coddingtonbear/baofeng-uv5r-usb-charger/hardware/buuc.kicad_pcb

## KiCad design hardware/buuc.kicad_pcb (2017-10-15)

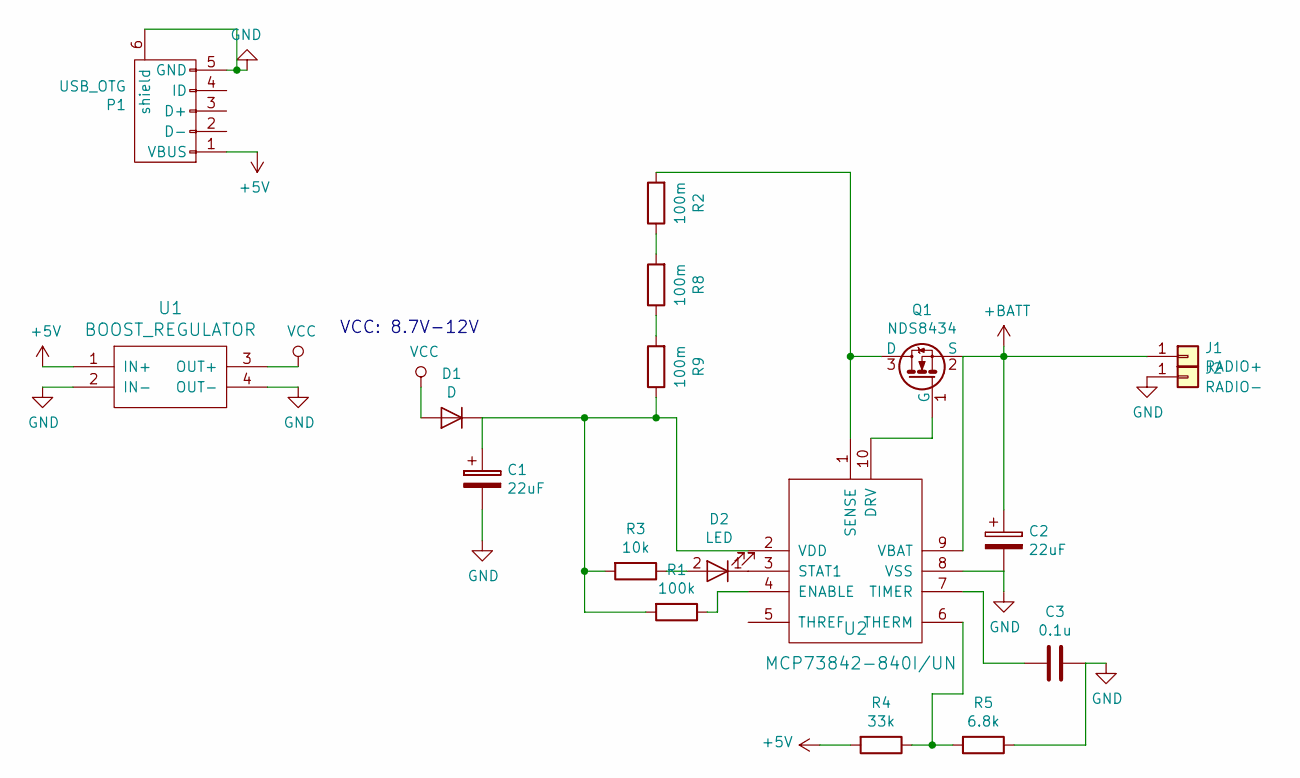
[picture p1: schematic buuc.sch]

Parts:
C1, C2: 22uF; C_1206_HandSoldering
C3: 0.1u; 0805_Milling
D1: D; DO-214AA-SMB
D2: LED; 0805_Milling
J1: RADIO+; TAB
J2: RADIO-; TAB
P1: USB_OTG; UJ2-MIBH-4-SMT
Q1: NDS8434
R1: 100k; 0805_Milling
R2, R8, R9: 100m; 0805_Milling
R3: 10k; 0805_Milling
R4: 33k; 0805_Milling
R5: 6.8k; 0805_Milling
U1: BOOST_REGULATOR
U2: MCP73842-840I/UN; MSOP-10

Connections:
+5V: P1.1 (VBUS), R4.2, U1.1 (IN+)
+BATT: C2.1, J1.1, Q1.2 (S), U2.9 (VBAT)
GND: C1.2, C2.2, C3.1, J2.1, P1.5 (GND), P1.6 (shield), R5.1, U1.2 (IN-), U1.4 (OUT-), U2.8 (VSS)
unnamed: C1.1, D1.1 (K), R1.2, R3.2, R9.1, U2.2 (VDD)
unnamed: C3.2, U2.7 (TIMER)
unnamed: D2.1 (K), U2.3 (STAT1)
unnamed: D2.2 (A), R3.1
unnamed: Q1.1 (G), U2.10 (DRV)
unnamed: Q1.3 (D), R2.2, U2.1 (SENSE)
unnamed: R1.1, U2.4 (ENABLE)
unnamed: R2.1, R8.2
unnamed: R4.1, R5.2, U2.6 (THERM)
unnamed: R8.1, R9.2
VCC: D1.2 (A), U1.3 (OUT+)

Notes on the sheet:
VCC: 8.7V-12V

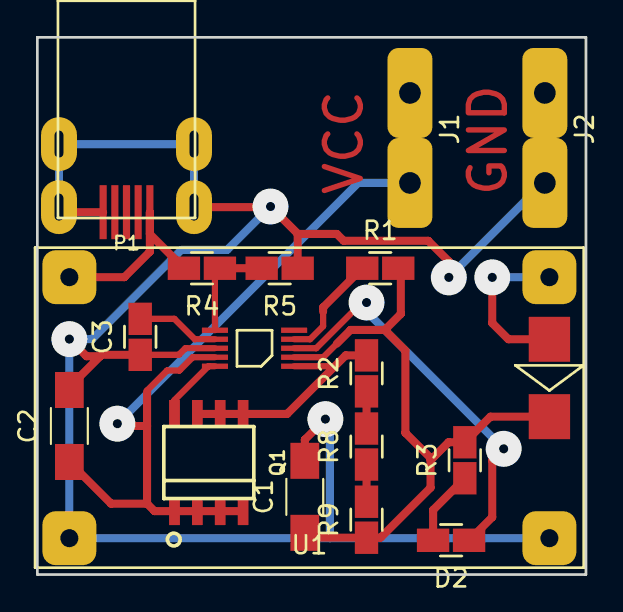
[picture p2: board buuc.kicad_pcb from above]

Board: 2 copper layers, 30.5 x 29.8 mm, 18 parts (0 on the bottom side), 14 nets.
