coddingtonbear/baofeng-uv5r-usb-charger/(commit log)

2017-09-06 Adding new hardware designs.
    [buuc.kicad_pcb, buuc.sch]
2017-09-06 Whoops; using the wrong footprint and chip diagram.
    [buuc.kicad_pcb, buuc.sch]
2017-09-06 Minor changes to ground plane clearances to improve milling.
    [buuc.kicad_pcb]
2017-09-06 Committing changes from yesterday.
    [buuc.kicad_pcb, buuc.sch]
2017-09-10 Minor pcb changes.
    [buuc.kicad_pcb]
2017-09-10 Minor updates; fixing size of boost regulator board.
    [buuc.kicad_pcb]
2017-09-14 Updating schematics.
    [buuc.kicad_pcb]
2017-09-14 Adding MIC2005 current limiting IC; I haven't even soldered everything together, but it's pretty clear this will be necessary.
    [buuc.kicad_pcb, buuc.sch]
2017-09-15 Swapping resistor footprint for one that's a bit easier to solder onto a milled board; minor move of the USB connector.
    [buuc.kicad_pcb, buuc.sch]
2017-09-15 Slightly more space is necessary.
    [buuc.kicad_pcb]
2017-09-15 Even more space...
    [buuc.kicad_pcb]
2017-09-17 Apparently: active low. FFS.
    [buuc.kicad_pcb, buuc.sch]
2017-09-19 Adding extra pads allowing me to fine-tune the consumed current; adding unpopulated bypass resistor around the MIC2005.
    [buuc.kicad_pcb, buuc.sch]
2017-09-19 fixup! Adding extra pads allowing me to fine-tune the consumed current; adding unpopulated bypass resistor around the MIC2005.
    [buuc.sch]
2017-09-19 Updating to use a grid of current sense resistors for configurability.
    [buuc.kicad_pcb]
2017-09-23 Switch to through-hole USB adapter; the SMD component is a little too jiggly, and I don't have better ones on-hand at the moment.
    [buuc.kicad_pcb, buuc.sch]
2017-10-02 If I'm going to do this another time, I might as well make it count.
    [buuc.kicad_pcb, buuc.sch]
2017-10-15 Slightly more compact.
    [buuc.kicad_pcb]
2017-10-15 Updating to use slightly-wider tracks.
    [buuc.kicad_pcb]
